UCSD-Quadcopter-Class/quad-hardware-brahman/quadcopter.brd

## EAGLE design quadcopter.brd (2017-05-25)

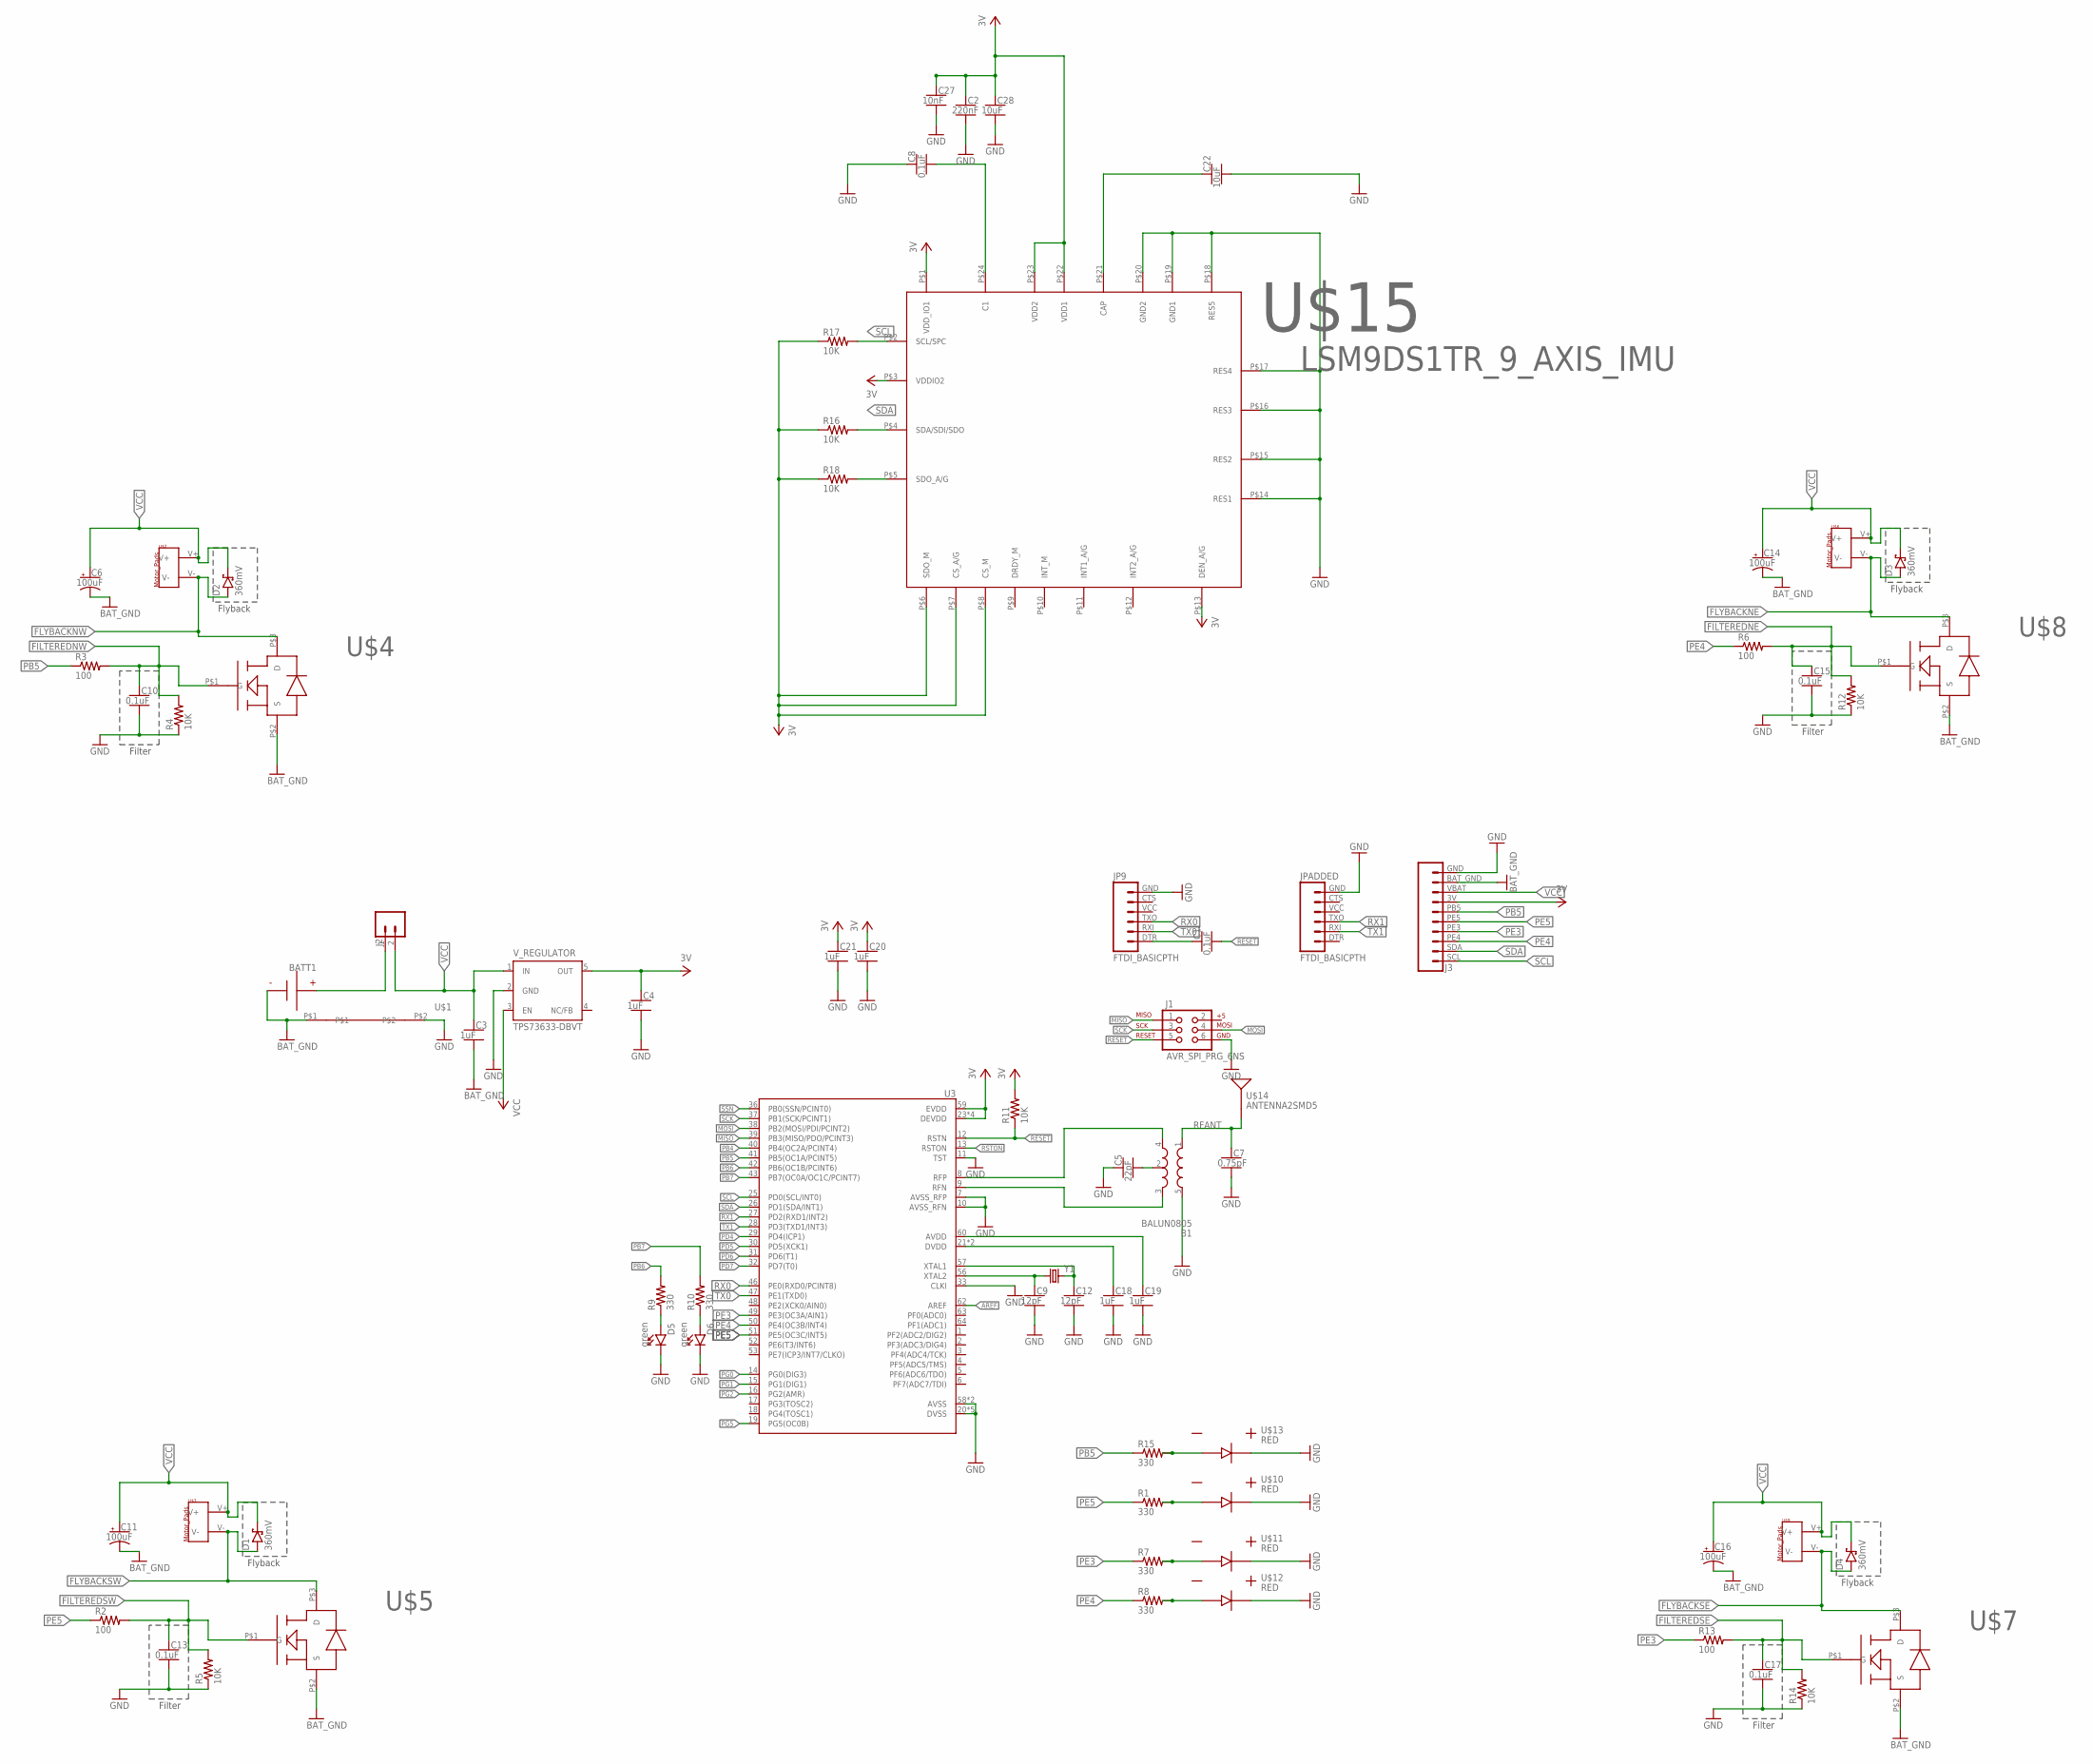
[picture p4: schematic quadcopter.sch]

Parts:
B1: BALUN0805; BALUN
BATT1: BATTERY-HUBSAN-W/HOLDER; BATTERY-W/HOLDER-380MAH-HUBSAN
C1, C8, C10, C13, C15, C17: 0.1uF; CAPC2012X140_HS
C2: 220nF; CAPC2012X140_HS
C3, C4, C18, C19, C20, C21: 1uF; CAPC2012X140_HS
C5: 22pF; CAPC2012X140_HS
C6, C11, C14, C16: 100uF; CAPMP7343X310_HS
C7: 0.75pF; CAPC2012X140_HS
C9, C12: 12pF; CAPC2012X140_HS
C22, C28: 10uF; CAPC2012X140_HS
C27: 10nF; CAPC2012X140_HS
D1, D2, D3, D4: 360mV; SOD3716X135_HS
D5, D6: green; LEDSC125X200X120-2_HS
J1: AVR_SPI_PRG_6NS; 2X3-NS
J2: MALE_HEADER_2POS-2X1-0.1IN; MALE_HEADER_2X1_0.1IN
J3: BREAKOUT_HEADERTH-254X10; HDRV10W63P254_10X1_2540X254H838_HS
JP9: FTDI_BASICPTH; FTDI_BASIC
JPADDED: FTDI_BASICPTH; FTDI_BASIC
R1, R7, R8, R9, R10, R15: 330; RESC2012X60_HS
R2, R3, R6, R13: 100; RESC2012X60_HS
R4, R5, R11, R12, R14, R16, R17, R18: 10K; RESC2012X60_HS
U3: ATMEGA128RFA1; QFN-64
U$1: NET_BRIDGE
U$2, U$3, U$6, U$9: MOTOR_PADS
U$4, U$5, U$7, U$8: N_CHANNEL_MOSFET; N-CHANNEL-MOSFET
U$10, U$11, U$12, U$13: RED; RED_LED
U$14: ANTENNA2SMD5; ANTENNA-CHIP5
U$15: LSM9DS1TR_9_AXIS_IMU
V_REGULATOR: TPS73633-DBVT; SOT23-DBV
Y1: CRYSTAL5X3; CRYSTAL-SMD-5X3

Connections:
3V: C2.1, C4.1, C20.1, C21.1, C27.1, C28.1, J3.3V, R11.2, R16.1, R17.1, R18.1, U3.23 (DEVDD), U3.34 (DEVDD), U3.44 (DEVDD), U3.54 (DEVDD), U3.59 (EVDD), U$15.P$1 (VDD_IO1), U$15.P$3 (VDDIO2), U$15.P$6 (SDO_M), U$15.P$7 (CS_A/G), U$15.P$8 (CS_M), U$15.P$13 (DEN_A/G), U$15.P$22 (VDD1), U$15.P$23 (VDD2), V_REGULATOR.5 (OUT)
AREF: U3.62 (AREF)
AVDD: C19.1, U3.60 (AVDD)
BAT_GND: BATT1.- (N), C3.2, C6.2 (-), C11.2 (-), C14.2 (-), C16.2 (-), J3.BAT_GND, U$1.P$1, U$4.P$2 (S), U$5.P$2 (S), U$7.P$2 (S), U$8.P$2 (S)
DVDD: C18.1, U3.21 (DVDD), U3.22 (DVDD)
FILTEREDNE: C15.1, R6.2, R12.2, U$8.P$1 (G)
FILTEREDNW: C10.1, R3.2, R4.2, U$4.P$1 (G)
FILTEREDSE: C17.1, R13.2, R14.2, U$7.P$1 (G)
FILTEREDSW: C13.1, R2.2, R5.2, U$5.P$1 (G)
FLYBACKNE: D3.A, U$6.V-, U$8.P$3 (D)
FLYBACKNW: D2.A, U$2.V-, U$4.P$3 (D)
FLYBACKSE: D4.A, U$7.P$3 (D), U$9.V-
FLYBACKSW: D1.A, U$3.V-, U$5.P$3 (D)
GND: B1.5 (GND), C2.2, C4.2, C5.1, C7.2, C8.1, C9.2, C10.2, C12.2, C13.2, C15.2, C17.2, C18.2, C19.2, C20.2, C21.2, C22.2, C27.2, C28.2, D5.C, D6.C, J1.6, J3.GND, JP9.GND (6), JPADDED.GND (6), R4.1, R5.1, R12.1, R14.1, U3.7 (AVSS_RFP), U3.10 (AVSS_RFN), U3.11 (TST), U3.20 (DVSS), U3.24 (DVSS), U3.33 (CLKI), U3.35 (DVSS), U3.45 (DVSS), U3.55 (DVSS), U3.58 (AVSS), U3.61 (AVSS), U$1.P$2, U$10.P$3 (PAS_POS), U$11.P$3 (PAS_POS), U$12.P$3 (PAS_POS), U$13.P$3 (PAS_POS), U$15.P$14 (RES1), U$15.P$15 (RES2), U$15.P$16 (RES3), U$15.P$17 (RES4), U$15.P$18 (RES5), U$15.P$19 (GND1), U$15.P$20 (GND2), V_REGULATOR.2 (GND)
MISO: J1.1, U3.39 (PB3(MISO/PDO/PCINT3))
MOSI: J1.4, U3.38 (PB2(MOSI/PDI/PCINT2))
unnamed: R1.2, U$10.P$1 (PAS_NEG)
unnamed: C12.1, U3.57 (XTAL1), Y1.3 (2)
unnamed: C9.1, U3.56 (XTAL2), Y1.1
unnamed: R7.2, U$11.P$1 (PAS_NEG)
unnamed: BATT1.+, J2.1
unnamed: B1.2 (GND), C5.2
unnamed: D5.A, R9.1
unnamed: R8.2, U$12.P$1 (PAS_NEG)
unnamed: R18.2, U$15.P$5 (SDO_A/G)
unnamed: R15.2, U$13.P$1 (PAS_NEG)
unnamed: D6.A, R10.1
unnamed: C8.2, U$15.P$24 (C1)
unnamed: C22.1, U$15.P$21 (CAP)
unnamed: C1.1, JP9.DTR (1)
PB4: U3.40 (PB4(OC2A/PCINT4))
PB5: J3.PB5, R3.1, R15.1, U3.41 (PB5(OC1A/PCINT5))
PB6: R9.2, U3.42 (PB6(OC1B/PCINT6))
PB7: R10.2, U3.43 (PB7(OC0A/OC1C/PCINT7))
PD4: U3.29 (PD4(ICP1))
PD5: U3.30 (PD5(XCK1))
PD6: U3.31 (PD6(T1))
PD7: U3.32 (PD7(T0))
PE3: J3.PE3, R7.1, R13.1, U3.49 (PE3(OC3A/AIN1))
PE4: J3.PE4, R6.1, R8.1, U3.50 (PE4(OC3B/INT4))
PE5: J3.PE5 (P5), R1.1, R2.1, U3.51 (PE5(OC3C/INT5))
PG0: U3.14 (PG0(DIG3))
PG1: U3.15 (PG1(DIG1))
PG2: U3.16 (PG2(AMR))
PG5: U3.19 (PG5(OC0B))
RESET: C1.2, J1.5, R11.1, U3.12 (RSTN)
RFANT: B1.1 (IN), C7.1, U$14.FEED
RFN: B1.3 (OUT2), U3.9 (RFN)
RFP: B1.4 (OUT1), U3.8 (RFP)
RSTON: U3.13 (RSTON)
RX0: JP9.TXO (3), U3.46 (PE0(RXD0/PCINT8))
RX1: JPADDED.TXO (3), U3.27 (PD2(RXD1/INT2))
SCK: J1.3, U3.37 (PB1(SCK/PCINT1))
SCL: J3.SCL, R17.2, U3.25 (PD0(SCL/INT0)), U$15.P$2 (SCL/SPC)
SDA: J3.SDA, R16.2, U3.26 (PD1(SDA/INT1)), U$15.P$4 (SDA/SDI/SDO)
SSN: U3.36 (PB0(SSN/PCINT0))
TX0: JP9.RXI (2), U3.47 (PE1(TXD0))
TX1: JPADDED.RXI (2), U3.28 (PD3(TXD1/INT3))
VCC: C3.1, C6.1 (+), C11.1 (+), C14.1 (+), C16.1 (+), D1.C, D2.C, D3.C, D4.C, J2.2, J3.VBAT, U$2.V+, U$3.V+, U$6.V+, U$9.V+, V_REGULATOR.1 (IN), V_REGULATOR.3 (EN)

Notes on the sheet:
Filter
Flyback

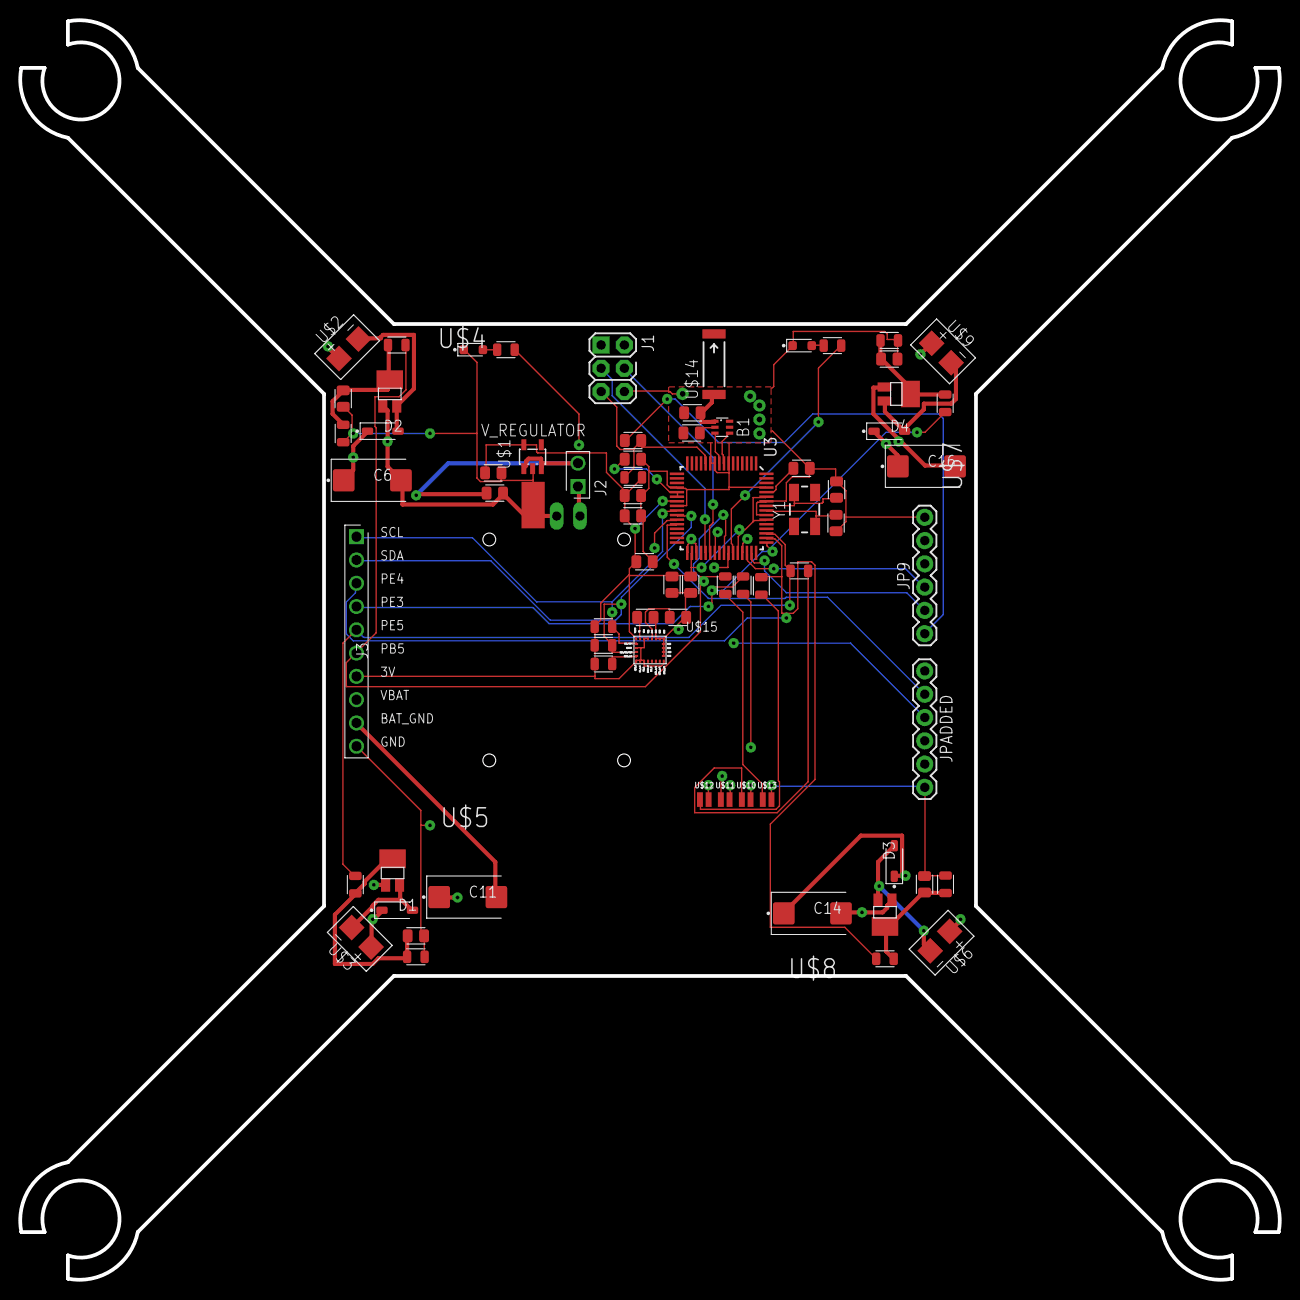
[picture p5: board quadcopter.brd from above]

Board: 4 copper layers, 137.4 x 137.4 mm, 73 parts (1 on the bottom side), 47 nets.
