UCSD-Quadcopter-Class/quad-hardware-brahman/ATmega128RFA1-DevBoard.brd

## EAGLE design ATmega128RFA1-DevBoard.brd (2017-04-16)

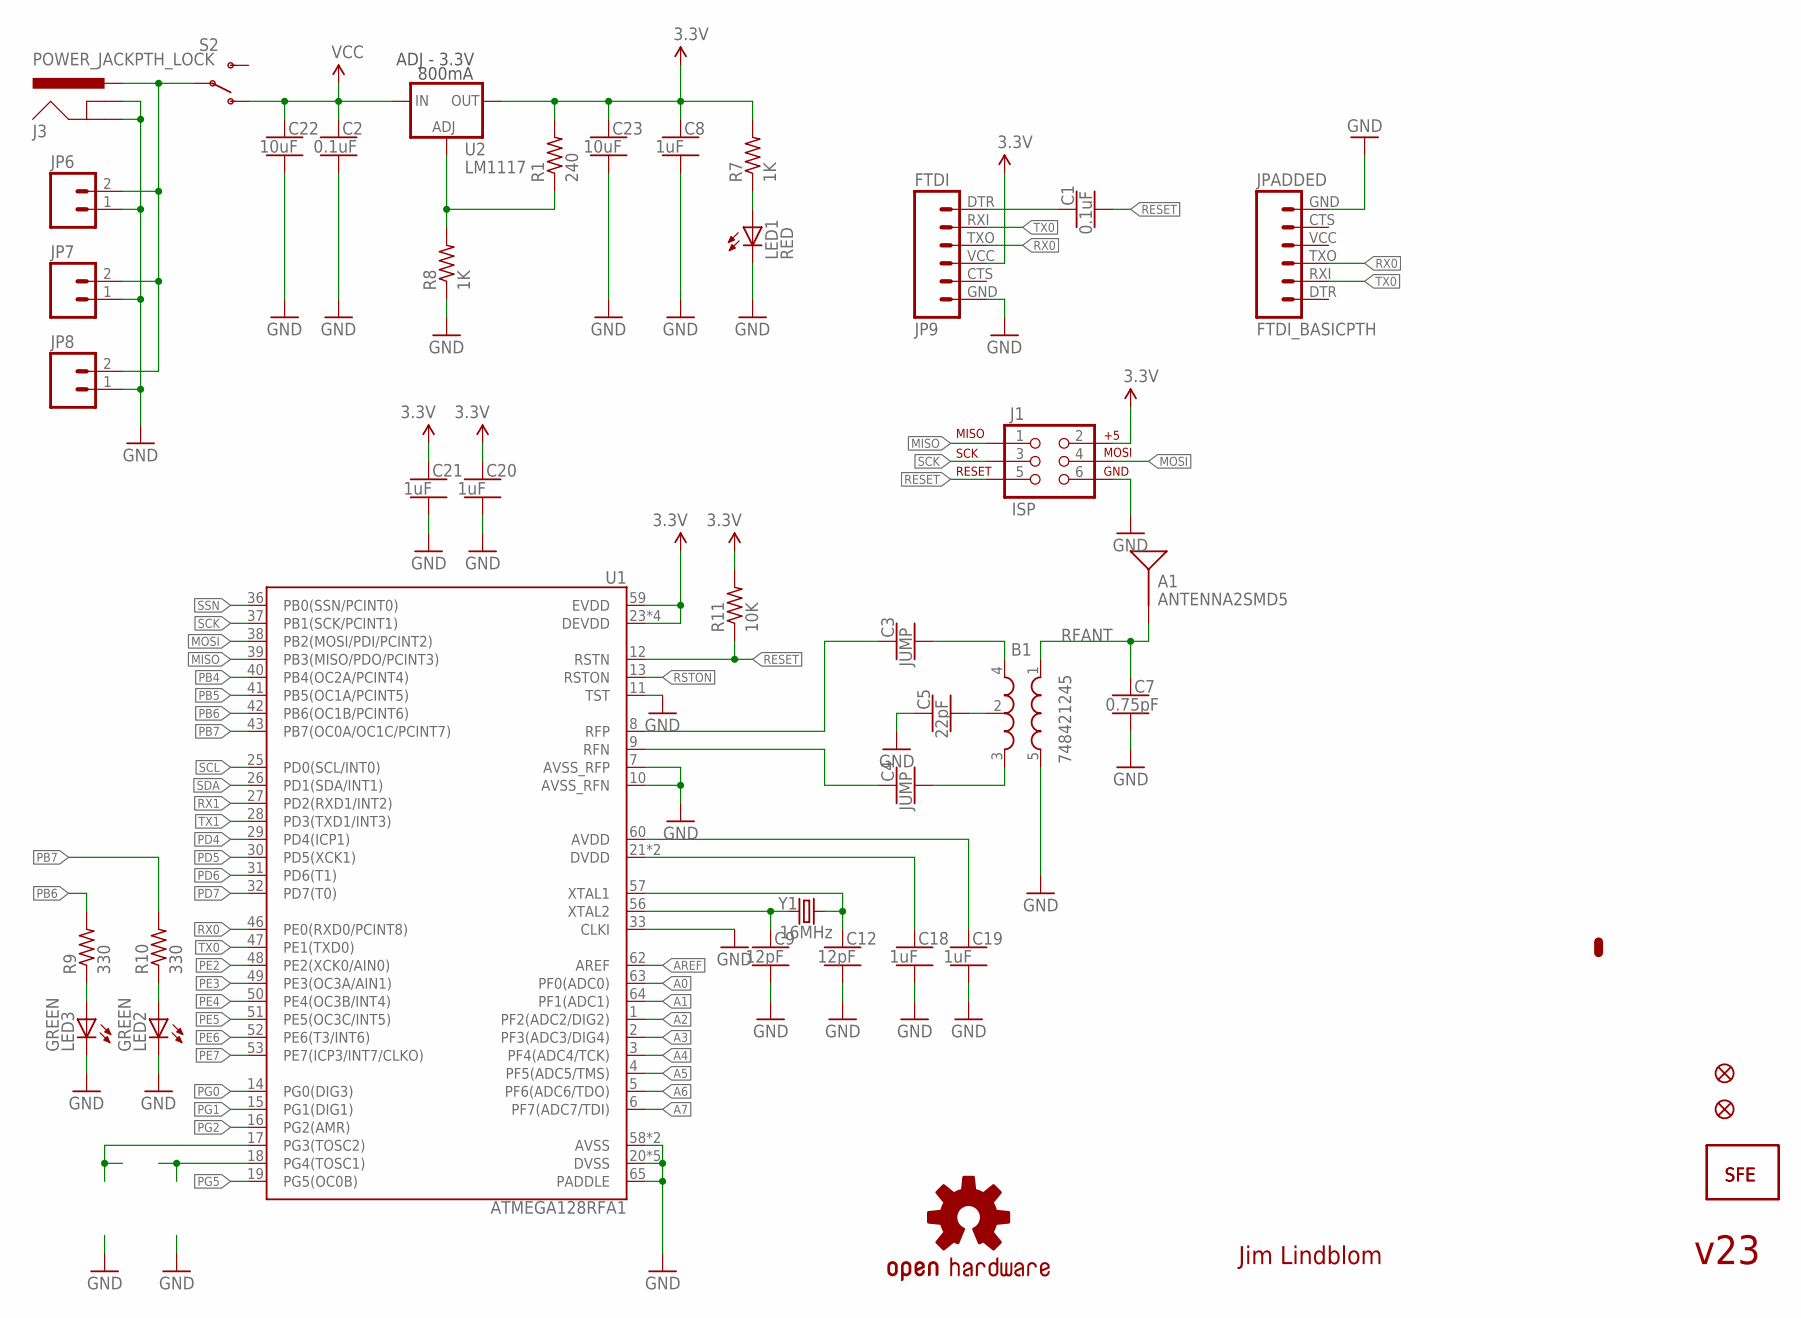
[picture p6: schematic ATmega128RFA1-DevBoard.sch]

Parts:
A1: ANTENNA2SMD5; ANTENNA-CHIP5
B1: 748421245; BALUN
C1, C2: 0.1uF; CAPC2012X140_HS
C3, C4: JUMP; CAPC2012X140_HS
C5: 22pF; CAPC2012X140_HS
C7: 0.75pF; CAPC2012X140_HS
C8, C18, C19, C20, C21: 1uF; CAPC2012X140_HS
C9, C12: 12pF; CAPC2012X140_HS
C22, C23: 10uF; CAPC2012X140_HS
FID1, FID2: FIDUCIALUFIDUCIAL; MICRO-FIDUCIAL
J1: ISP; 2X3-NS
J3: POWER_JACKPTH_LOCK; POWER_JACK_PTH_LOCK
JP4, JP10: LOGO-SFENEW; SFE-NEW-WEBLOGO
JP6: M02JST-PTH-2; JST-2-PTH
JP7: M021X02_NO_SILK; 1X02_NO_SILK
JP8: M023.5MM-NO_SILK; SCREWTERMINAL-3.5MM-2-NS
JP9: FTDI; FTDI_BASIC
JPADDED: FTDI_BASICPTH; FTDI_BASIC
LED1: RED; LED-0603
LED2, LED3: GREEN; LED-0603
R1: 240; RESC2012X60_HS
R7, R8: 1K; RESC2012X60_HS
R9, R10: 330; RESC2012X60_HS
R11: 10K; RESC2012X60_HS
S2: SWITCH-SPST-SMD-A
U1: ATMEGA128RFA1; QFN-64
U2: LM1117; SOT223
U$1: OSHW-LOGOS; OSHW-LOGO-S
Y1: 16MHz; CRYSTAL-SMD-5X3

Connections:
3.3V: C8.1, C20.1, C21.1, C23.1, J1.2, JP9.VCC (4), R1.2, R7.2, R11.2, U1.23 (DEVDD), U1.34 (DEVDD), U1.44 (DEVDD), U1.54 (DEVDD), U1.59 (EVDD), U2.2 (OUT)
A0: U1.63 (PF0(ADC0))
A1: U1.64 (PF1(ADC1))
A2: U1.1 (PF2(ADC2/DIG2))
A3: U1.2 (PF3(ADC3/DIG4))
A4: U1.3 (PF4(ADC4/TCK))
A5: U1.4 (PF5(ADC5/TMS))
A6: U1.5 (PF6(ADC6/TDO))
A7: U1.6 (PF7(ADC7/TDI))
AREF: U1.62 (AREF)
AVDD: C19.1, U1.60 (AVDD)
DTR: C1.1, JP9.DTR (1)
DVDD: C18.1, U1.21 (DVDD), U1.22 (DVDD)
FB: R1.1, R8.2, U2.1 (ADJ)
GND: B1.5 (GND), C2.2, C5.1, C7.2, C8.2, C9.2, C12.2, C18.2, C19.2, C20.2, C21.2, C22.2, C23.2, J1.6, J3.GND, J3.GNDBREAK, JP6.1, JP7.1, JP8.1, JP9.GND (6), JPADDED.GND (6), LED1.C, LED2.C, LED3.C, R8.1, U1.7 (AVSS_RFP), U1.10 (AVSS_RFN), U1.11 (TST), U1.20 (DVSS), U1.24 (DVSS), U1.33 (CLKI), U1.35 (DVSS), U1.45 (DVSS), U1.55 (DVSS), U1.58 (AVSS), U1.61 (AVSS), U1.65 (PADDLE)
MISO: J1.1, U1.39 (PB3(MISO/PDO/PCINT3))
MOSI: J1.4, U1.38 (PB2(MOSI/PDI/PCINT2))
unnamed: LED1.A, R7.1
unnamed: C12.1, U1.57 (XTAL1), Y1.3 (2)
unnamed: C9.1, U1.56 (XTAL2), Y1.1
unnamed: B1.2 (GND), C5.2
unnamed: LED3.A, R9.1
unnamed: J3.PWR, JP6.2, JP7.2, JP8.2, S2.2
unnamed: B1.4 (OUT1), C3.2
unnamed: B1.3 (OUT2), C4.2
unnamed: LED2.A, R10.1
PB4: U1.40 (PB4(OC2A/PCINT4))
PB5: U1.41 (PB5(OC1A/PCINT5))
PB6: R9.2, U1.42 (PB6(OC1B/PCINT6))
PB7: R10.2, U1.43 (PB7(OC0A/OC1C/PCINT7))
PD4: U1.29 (PD4(ICP1))
PD5: U1.30 (PD5(XCK1))
PD6: U1.31 (PD6(T1))
PD7: U1.32 (PD7(T0))
PE2: U1.48 (PE2(XCK0/AIN0))
PE3: U1.49 (PE3(OC3A/AIN1))
PE4: U1.50 (PE4(OC3B/INT4))
PE5: U1.51 (PE5(OC3C/INT5))
PE6: U1.52 (PE6(T3/INT6))
PE7: U1.53 (PE7(ICP3/INT7/CLKO))
PG0: U1.14 (PG0(DIG3))
PG1: U1.15 (PG1(DIG1))
PG2: U1.16 (PG2(AMR))
PG5: U1.19 (PG5(OC0B))
RESET: C1.2, J1.5, R11.1, U1.12 (RSTN)
RFANT: A1.FEED, B1.1 (IN), C7.1
RFN: C4.1, U1.9 (RFN)
RFP: C3.1, U1.8 (RFP)
RSTON: U1.13 (RSTON)
RX0: JP9.TXO (3), U1.46 (PE0(RXD0/PCINT8))
RX1: U1.27 (PD2(RXD1/INT2))
SCK: J1.3, U1.37 (PB1(SCK/PCINT1))
SCL: U1.25 (PD0(SCL/INT0))
SDA: U1.26 (PD1(SDA/INT1))
SSN: U1.36 (PB0(SSN/PCINT0))
TX0: JP9.RXI (2), U1.47 (PE1(TXD0))
TX1: U1.28 (PD3(TXD1/INT3))
VCC: C2.1, C22.1, S2.1 (O), U2.3 (IN)

Notes on the sheet:
Jim Lindblom
800mA
ADJ - 3.3V
v23

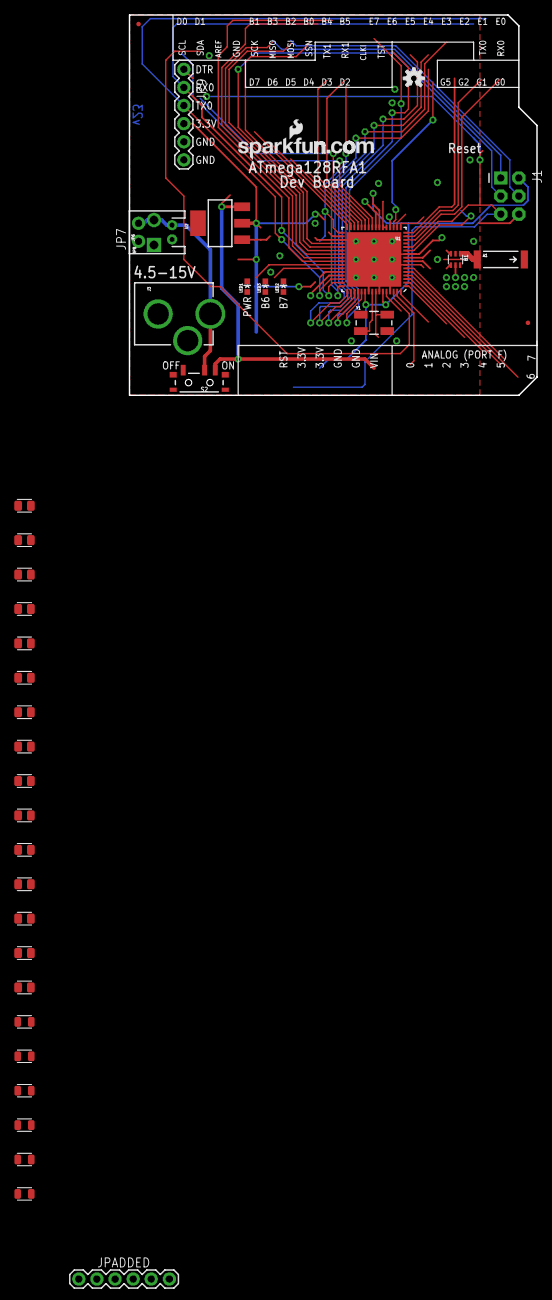
[picture p7: board ATmega128RFA1-DevBoard.brd from above]

Board: 2 copper layers, 57.1 x 53.3 mm, 42 parts (1 on the bottom side), 27 nets.
