UCSD-Quadcopter-Class/quad-hardware-brahman/(commit log)

2017-04-16 My lbr
    [PartList.xlsx]
2017-04-16 imu/motor drive/microcontroller added
    need to ask prof questions and do powersupply/leds/breakout header
    [ATmega128RFA1-DevBoard.brd, ATmega128RFA1-DevBoard.sch, quadcopter.sch]
2017-04-20 lab 4 complete
    [quadcopter.sch]
2017-04-20 adding LED data sheet
2017-04-27 instructior review of original schematic
2017-05-01 finished lab 7
    [quadcopter.brd, quadcopter.sch]
2017-05-04 added board review questions
2017-05-11 adding their questions about our board
2017-05-14 more schematic comments from swanson
2017-05-15 made changes to schematic/board per the comments the prof made
    [quadcopter.brd, quadcopter.sch]
2017-05-16 schematic changes for prof
    [quadcopter.sch]
2017-05-16 more changes made to board/schematic
    [quadcopter.brd, quadcopter.sch]
2017-05-17 schematic and board no longer inconsistent
    [quadcopter.brd, quadcopter.sch]
2017-05-18 made changes to pour
    need to change RED LED to be more like data sheet
    [quadcopter.brd, quadcopter.sch]
2017-05-23 made changes to board, almost done.
    [quadcopter.brd, quadcopter.sch]
2017-05-24 almost done with board, have 3 airwires
    [quadcopter.brd, quadcopter.sch]
2017-05-25 board 100% routed
    [quadcopter.brd, quadcopter.sch]
2017-05-25 added faraday cage to antenna
    [quadcopter.brd]
2017-05-25 fixed crystal routing and antenna routing, moved motor recouping caps, and replaced wrong filter diodes
    [quadcopter.brd, quadcopter.sch]
2017-05-25 fixed mosfet padding, rerouted, added gerber files
    [quadcopter.brd, quadcopter.sch]
